Yuchen-Song/Design-and-Manufacturing-II-Course-Project-Spring-2022/README.md

# Design-and-Manufacturing-II-Course-Project-Spring-2022
This is a repository for course materials of Design &amp; Manufacturing II  
You can find an introduction video to our project at [Intro](https://youtu.be/ErCT-_t35Jg)  
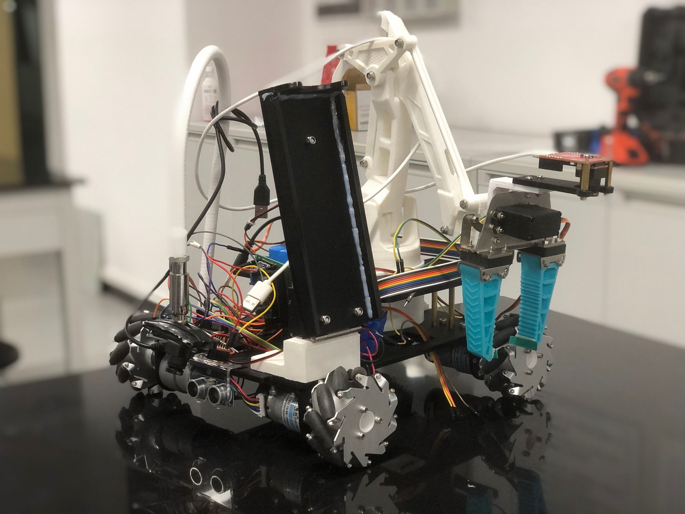
[picture p1: demo.jpg]
