Yuchen-Song/Design-and-Manufacturing-II-Course-Project-Spring-2022/stm32/HARDWARE/MOTOR/motor.h

#ifndef _MOTOR_H
#define _MOTOR_H
#include "sys.h"
	

//motor and Timer init
void F_MOTOR_Init(void);
void B_MOTOR_Init(void);


//控制两个马达的基础函数
void MOTOR_A(int state);
void MOTOR_B(int state);
void MOTOR_C(int state);
void MOTOR_D(int state);

//小车运动函数
void Car_Go(void);
void Car_Back(void);
void Car_Stop(void);
void Car_Turn_Left(void);
void Car_Turn_Right(void);
void Car_Move_Left(void);
void Car_Move_Right(void);
void Car_Turn_lLeft(void);
void Car_Turn_lRight(void);
void setcompare(int Lpwm,int Rpwm);
void pwm_control(int Lpwm,int Rpwm);
#endif
