Yuchen-Song/Design-and-Manufacturing-II-Course-Project-Spring-2022/stm32/HARDWARE/SONIC/sonic.c

#include "sonic.h"
#include "usart.h"
#include "delay.h"

void TIM5_Cap_Init(u16 arr,u16 psc)
{	 
	TIM_ICInitTypeDef  TIM5_ICInitStructure;
	GPIO_InitTypeDef GPIO_InitStructure;
	TIM_TimeBaseInitTypeDef  TIM_TimeBaseStructure;
  NVIC_InitTypeDef NVIC_InitStructure;

	RCC_APB1PeriphClockCmd(RCC_APB1Periph_TIM5, ENABLE);	//使能TIM5时钟
 	RCC_APB2PeriphClockCmd(RCC_APB2Periph_GPIOA, ENABLE);  //使能GPIOA时钟
	
	GPIO_InitStructure.GPIO_Pin  = GPIO_Pin_0;  //PA0 清除之前设置  
	GPIO_InitStructure.GPIO_Mode = GPIO_Mode_IPD; //PA0 输入  
	GPIO_Init(GPIOA, &GPIO_InitStructure);
	GPIO_ResetBits(GPIOA,GPIO_Pin_0);						 //PA0 下拉
	
	GPIO_InitStructure.GPIO_Pin  = GPIO_Pin_1;  //PA1 清除之前设置  
	GPIO_InitStructure.GPIO_Mode = GPIO_Mode_IPD; //PA1 输入  
	GPIO_Init(GPIOA, &GPIO_InitStructure);
	GPIO_ResetBits(GPIOA,GPIO_Pin_1);						 //PA1 下拉
	
	//初始化定时器5 TIM5	 
	TIM_TimeBaseStructure.TIM_Period = arr; //设定计数器自动重装值 
	TIM_TimeBaseStructure.TIM_Prescaler = psc; 	//预分频器   
	TIM_TimeBaseStructure.TIM_ClockDivision = TIM_CKD_DIV1; //设置时钟分割:TDTS = Tck_tim
	TIM_TimeBaseStructure.TIM_CounterMode = TIM_CounterMode_Up;  //TIM向上计数模式
	TIM_TimeBaseInit(TIM5, &TIM_TimeBaseStructure); //根据TIM_TimeBaseInitStruct中指定的参数初始化TIMx的时间基数单位
  
	//初始化TIM5输入捕获参数
	TIM5_ICInitStructure.TIM_Channel = TIM_Channel_1; //CC1S=01 	选择输入端 IC1映射到TI1上
	TIM5_ICInitStructure.TIM_ICPolarity = TIM_ICPolarity_Rising;	//上升沿捕获
	TIM5_ICInitStructure.TIM_ICSelection = TIM_ICSelection_DirectTI; //映射到TI1上
	TIM5_ICInitStructure.TIM_ICPrescaler = TIM_ICPSC_DIV1;	 //配置输入分频,不分频 
	TIM5_ICInitStructure.TIM_ICFilter = 0x00;//IC1F=0000 配置输入滤波器 不滤波
	TIM_ICInit(TIM5, &TIM5_ICInitStructure);
	
	//初始化TIM5输入捕获参数
	TIM5_ICInitStructure.TIM_Channel = TIM_Channel_2; //CC1S=01 	选择输入端 IC1映射到TI1上
	TIM5_ICInitStructure.TIM_ICPolarity = TIM_ICPolarity_Rising;	//上升沿捕获
	TIM5_ICInitStructure.TIM_ICSelection = TIM_ICSelection_DirectTI; //映射到TI1上
	TIM5_ICInitStructure.TIM_ICPrescaler = TIM_ICPSC_DIV1;	 //配置输入分频,不分频 
	TIM5_ICInitStructure.TIM_ICFilter = 0x00;//IC1F=0000 配置输入滤波器 不滤波
	TIM_ICInit(TIM5, &TIM5_ICInitStructure);
	
	//中断分组初始化
	NVIC_InitStructure.NVIC_IRQChannel = TIM5_IRQn;  //TIM3中断
	NVIC_InitStructure.NVIC_IRQChannelPreemptionPriority = 0;  //先占优先级2级
	NVIC_InitStructure.NVIC_IRQChannelSubPriority = 0;  //从优先级0级
	NVIC_InitStructure.NVIC_IRQChannelCmd = ENABLE; //IRQ通道被使能
	NVIC_Init(&NVIC_InitStructure);  //根据NVIC_InitStruct中指定的参数初始化外设NVIC寄存器 
	
	TIM_ITConfig(TIM5,TIM_IT_Update|TIM_IT_CC1|TIM_IT_CC2,ENABLE);//允许更新中断 ,允许CC1IE捕获中断	
	
  TIM_Cmd(TIM5,ENABLE); 	//使能定时器5
}

u8  TIM5CH1_CAPTURE_STA=0;	//输入捕获状态		    				
u16	TIM5CH1_CAPTURE_VAL;	//输入捕获值
u8  TIM5CH2_CAPTURE_STA=0;	//输入捕获状态		    				
u16	TIM5CH2_CAPTURE_VAL;	//输入捕获值
 
//定时器5中断服务程序	 
void TIM5_IRQHandler(void)
{
 	if((TIM5CH1_CAPTURE_STA&0X80)==0)//还未成功捕获	
	{	  
		if (TIM_GetITStatus(TIM5, TIM_IT_Update) != RESET)
		 
		{	    
			if(TIM5CH1_CAPTURE_STA&0X40)//已经捕获到高电平了
			{
				if((TIM5CH1_CAPTURE_STA&0X3F)==0X3F)//高电平太长了
				{
					TIM5CH1_CAPTURE_STA|=0X80;//标记成功捕获了一次
					TIM5CH1_CAPTURE_VAL=0XFFFF;
				}else TIM5CH1_CAPTURE_STA++;
			}	 
		}
	if (TIM_GetITStatus(TIM5, TIM_IT_CC1) != RESET)//捕获1发生捕获事件
		{	
			//printf("Captured!/n");
			if(TIM5CH1_CAPTURE_STA&0X40)		//捕获到一个下降沿 		
			{	  			
				//printf("Captured Down!/n");
				TIM5CH1_CAPTURE_STA|=0X80;		//标记成功捕获到一次高电平脉宽
				TIM5CH1_CAPTURE_VAL=TIM_GetCapture1(TIM5);
		   		TIM_OC1PolarityConfig(TIM5,TIM_ICPolarity_Rising); //CC1P=0 设置为上升沿捕获
			}else  								//还未开始,第一次捕获上升沿
			{
				//printf("Captured Up!/n");
				TIM5CH1_CAPTURE_STA=0;			//清空
				TIM5CH1_CAPTURE_VAL=0;
	 			TIM_SetCounter(TIM5,0);
				TIM5CH1_CAPTURE_STA|=0X40;		//标记捕获到了上升沿
		   		TIM_OC1PolarityConfig(TIM5,TIM_ICPolarity_Falling);		//CC1P=1 设置为下降沿捕获
			}		    
		}	
			
 	}
	if((TIM5CH2_CAPTURE_STA&0X80)==0)//还未成功捕获	
	{	  
		if (TIM_GetITStatus(TIM5, TIM_IT_Update) != RESET)
		 
		{	    
			if(TIM5CH2_CAPTURE_STA&0X40)//已经捕获到高电平了
			{
				if((TIM5CH2_CAPTURE_STA&0X3F)==0X3F)//高电平太长了
				{
					TIM5CH2_CAPTURE_STA|=0X80;//标记成功捕获了一次
					TIM5CH2_CAPTURE_VAL=0XFFFF;
				}else TIM5CH2_CAPTURE_STA++;
			}	 
		}
	if (TIM_GetITStatus(TIM5, TIM_IT_CC2) != RESET)//捕获1发生捕获事件
		{	
			//printf("Captured!/n");
			if(TIM5CH2_CAPTURE_STA&0X40)		//捕获到一个下降沿 		
			{	  			
				//printf("Captured Down!/n");
				TIM5CH2_CAPTURE_STA|=0X80;		//标记成功捕获到一次高电平脉宽
				TIM5CH2_CAPTURE_VAL=TIM_GetCapture2(TIM5);
		   		TIM_OC2PolarityConfig(TIM5,TIM_ICPolarity_Rising); //CC1P=0 设置为上升沿捕获
			}else  								//还未开始,第一次捕获上升沿
			{
				//printf("Captured Up!/n");
				TIM5CH2_CAPTURE_STA=0;			//清空
				TIM5CH2_CAPTURE_VAL=0;
	 			TIM_SetCounter(TIM5,0);
				TIM5CH2_CAPTURE_STA|=0X40;		//标记捕获到了上升沿
		   		TIM_OC2PolarityConfig(TIM5,TIM_ICPolarity_Falling);		//CC1P=1 设置为下降沿捕获
			}		    
		}
	}
 
    TIM_ClearITPendingBit(TIM5, TIM_IT_CC1|TIM_IT_CC2|TIM_IT_Update); //清除中断标志位
 
}


void TIM4_Cap_Init(u16 arr,u16 psc)
{	 
	TIM_ICInitTypeDef  TIM4_ICInitStructure;
	GPIO_InitTypeDef GPIO_InitStructure;
	TIM_TimeBaseInitTypeDef  TIM_TimeBaseStructure;
  NVIC_InitTypeDef NVIC_InitStructure;

	RCC_APB1PeriphClockCmd(RCC_APB1Periph_TIM4, ENABLE);	//使能TIM4时钟
 	RCC_APB2PeriphClockCmd(RCC_APB2Periph_GPIOB, ENABLE);  //使能GPIOB时钟
	
	GPIO_InitStructure.GPIO_Pin  = GPIO_Pin_8;  //PB8 清除之前设置  
	GPIO_InitStructure.GPIO_Mode = GPIO_Mode_IPD; //PB8 输入  
	GPIO_Init(GPIOB, &GPIO_InitStructure);
	GPIO_ResetBits(GPIOB,GPIO_Pin_8);						 //PB8 下拉
	
	
	//初始化定时器4 TIM4 
	TIM_TimeBaseStructure.TIM_Period = arr; //设定计数器自动重装值 
	TIM_TimeBaseStructure.TIM_Prescaler = psc; 	//预分频器   
	TIM_TimeBaseStructure.TIM_ClockDivision = TIM_CKD_DIV1; //设置时钟分割:TDTS = Tck_tim
	TIM_TimeBaseStructure.TIM_CounterMode = TIM_CounterMode_Up;  //TIM向上计数模式
	TIM_TimeBaseInit(TIM4, &TIM_TimeBaseStructure); //根据TIM_TimeBaseInitStruct中指定的参数初始化TIMx的时间基数单位
  
	//初始化TIM4输入捕获参数
	TIM4_ICInitStructure.TIM_Channel = TIM_Channel_3; //CC1S=01 	选择输入端 IC1映射到TI1上
	TIM4_ICInitStructure.TIM_ICPolarity = TIM_ICPolarity_Rising;	//上升沿捕获
	TIM4_ICInitStructure.TIM_ICSelection = TIM_ICSelection_DirectTI; //映射到TI1上
	TIM4_ICInitStructure.TIM_ICPrescaler = TIM_ICPSC_DIV1;	 //配置输入分频,不分频 
	TIM4_ICInitStructure.TIM_ICFilter = 0x00;//IC1F=0000 配置输入滤波器 不滤波
	TIM_ICInit(TIM4, &TIM4_ICInitStructure);
	
	//中断分组初始化
	NVIC_InitStructure.NVIC_IRQChannel = TIM4_IRQn;  //TIM3中断
	NVIC_InitStructure.NVIC_IRQChannelPreemptionPriority = 2;  //先占优先级2级
	NVIC_InitStructure.NVIC_IRQChannelSubPriority = 0;  //从优先级0级
	NVIC_InitStructure.NVIC_IRQChannelCmd = ENABLE; //IRQ通道被使能
	NVIC_Init(&NVIC_InitStructure);  //根据NVIC_InitStruct中指定的参数初始化外设NVIC寄存器 
	
	TIM_ITConfig(TIM4,TIM_IT_Update|TIM_IT_CC3,ENABLE);//允许更新中断 ,允许更新中断和捕获中断	
	
  TIM_Cmd(TIM4,ENABLE); 	//使能TIM4
}

u8  TIM4CH3_CAPTURE_STA=0;	//输入捕获状态		    				
u16	TIM4CH3_CAPTURE_VAL;	//输入捕获值
 
//定时器5中断服务程序	 
void TIM4_IRQHandler(void)
{
 	if((TIM4CH3_CAPTURE_STA&0X80)==0)//还未成功捕获	
	{	  
		if (TIM_GetITStatus(TIM4, TIM_IT_Update) != RESET)
		 
		{	    
			if(TIM4CH3_CAPTURE_STA&0X40)//已经捕获到高电平了
			{
				if((TIM4CH3_CAPTURE_STA&0X3F)==0X3F)//高电平太长了
				{
					TIM4CH3_CAPTURE_STA|=0X80;//标记成功捕获了一次
					TIM4CH3_CAPTURE_VAL=0XFFFF;
				}else TIM4CH3_CAPTURE_STA++;
			}	 
		}
	if (TIM_GetITStatus(TIM4, TIM_IT_CC3) != RESET)//捕获1发生捕获事件
		{	
			//printf("Captured!/n");
			if(TIM4CH3_CAPTURE_STA&0X40)		//捕获到一个下降沿 		
			{	  			
				//printf("Captured Down!/n");
				TIM4CH3_CAPTURE_STA|=0X80;		//标记成功捕获到一次高电平脉宽
				TIM4CH3_CAPTURE_VAL=TIM_GetCapture3(TIM4);
				TIM_OC3PolarityConfig(TIM4,TIM_ICPolarity_Rising); //CC1P=0 设置为上升沿捕获
			}
			else  								//还未开始,第一次捕获上升沿
			{
				//printf("Captured Up!/n");
				TIM4CH3_CAPTURE_STA=0;			//清空
				TIM4CH3_CAPTURE_VAL=0;
	 			TIM_SetCounter(TIM4,0);
				TIM4CH3_CAPTURE_STA|=0X40;		//标记捕获到了上升沿
				TIM_OC3PolarityConfig(TIM4,TIM_ICPolarity_Falling);		//CC1P=1 设置为下降沿捕获
			}		    
		}	
 	}
	TIM_ClearITPendingBit(TIM4, TIM_IT_CC3|TIM_IT_Update); //清除中断标志位
}

void HC_SR04_Init(void)
{
	GPIO_InitTypeDef GPIO_InitStructure;
	RCC_APB2PeriphClockCmd(RCC_APB2Periph_GPIOA, ENABLE);	 //??PA????
 	RCC_APB2PeriphClockCmd(RCC_APB2Periph_GPIOC, ENABLE);  //使能GPIOC时钟
	
	GPIO_InitStructure.GPIO_Pin = GPIO_Pin_4;				 // ??????(Trig)??PA4
	GPIO_InitStructure.GPIO_Mode = GPIO_Mode_Out_PP; 		 //????
	GPIO_InitStructure.GPIO_Speed = GPIO_Speed_50MHz;		 //IO????50MHz
	GPIO_Init(GPIOA, &GPIO_InitStructure);	
	
	GPIO_ResetBits(GPIOA,GPIO_Pin_4);
	
	GPIO_InitStructure.GPIO_Pin = GPIO_Pin_4;				 // ??????(Trig)??PA4
	GPIO_InitStructure.GPIO_Mode = GPIO_Mode_Out_PP; 		 //????
	GPIO_InitStructure.GPIO_Speed = GPIO_Speed_50MHz;		 //IO????50MHz
	GPIO_Init(GPIOC, &GPIO_InitStructure);	
	
	GPIO_ResetBits(GPIOC,GPIO_Pin_4);
	
	GPIO_InitStructure.GPIO_Pin = GPIO_Pin_5;				 // ??????(Trig)??PA4
	GPIO_InitStructure.GPIO_Mode = GPIO_Mode_Out_PP; 		 //????
	GPIO_InitStructure.GPIO_Speed = GPIO_Speed_50MHz;		 //IO????50MHz
	GPIO_Init(GPIOC, &GPIO_InitStructure);	
	
	GPIO_ResetBits(GPIOC,GPIO_Pin_5);
}

float HC_SR04_GetDis(u8 a)
{
	float Distance = 0.0;
	u32 temp=0; 
	if (a == 1)
	{
		GPIO_SetBits(GPIOA,GPIO_Pin_4);    //TRIG??
		delay_us(20);
		GPIO_ResetBits(GPIOA,GPIO_Pin_4);  //TRIG??

		if(TIM5CH1_CAPTURE_STA&0X80)//成功捕获到了一次上升沿
		{
			temp=TIM5CH1_CAPTURE_STA&0X3F;
			temp*=65536;//溢出时间总和
			temp+=TIM5CH1_CAPTURE_VAL;//得到总的高电平时间
			Distance = temp*0.017;
			printf("HIGH-1:%.2f cm\r\n",Distance);//打印总的高点平时间
			TIM5CH1_CAPTURE_STA=0;//开启下一次捕获
			return Distance;
		}
	}
	else if (a == 3)
	{
		GPIO_SetBits(GPIOC,GPIO_Pin_4);    //TRIG??
		delay_us(20);
		GPIO_ResetBits(GPIOC,GPIO_Pin_4);  //TRIG??

		if(TIM5CH2_CAPTURE_STA&0X80)//成功捕获到了一次上升沿
			{
				temp=TIM5CH2_CAPTURE_STA&0X3F;
				temp*=65536;//溢出时间总和
				temp+=TIM5CH2_CAPTURE_VAL;//得到总的高电平时间
				Distance = temp*0.017;
				printf("HIGH-2:%.2f cm\r\n",Distance);//打印总的高点平时间
				TIM5CH2_CAPTURE_STA=0;//开启下一次捕获
				return Distance;
		}
	}
	else if (a == 2)
	{
		GPIO_SetBits(GPIOC,GPIO_Pin_5);    //TRIG??
		delay_us(20);
		GPIO_ResetBits(GPIOC,GPIO_Pin_5);  //TRIG??

		if(TIM4CH3_CAPTURE_STA&0X80)//成功捕获到了一次上升沿
		{
			temp=TIM4CH3_CAPTURE_STA&0X3F;
			temp*=65536;//溢出时间总和
			temp+=TIM4CH3_CAPTURE_VAL;//得到总的高电平时间
			Distance = temp*0.017;
			printf("HIGH-3:%.2f cm\r\n",Distance);//打印总的高点平时间
			TIM4CH3_CAPTURE_STA=0;//开启下一次捕获
			return Distance;
		}
	}
}
