Yuchen-Song/Design-and-Manufacturing-II-Course-Project-Spring-2022/stm32/HARDWARE/MPU6050/mpu6050.h

#ifndef _MPU6050_H__
#define _MPU6050_H__

#include "stm32f10x.h"

#define DEV_ADDR	0xD0	// 6050 器件地址

//-----------------------------------------
// 定义MPU6050内部地址
//-----------------------------------------
#define	SMPLRT_DIV		0x19	//陀螺仪采样率，典型值：0x07(125Hz)
#define	CONFIG			0x1A	//低通滤波频率，典型值：0x06(5Hz)
#define	GYRO_CONFIG		0x1B	//陀螺仪自检及测量范围，典型值：0x18(不自检，2000deg/s)
#define	ACCEL_CONFIG	0x1C	//加速计自检、测量范围及高通滤波频率，典型值：0x01(不自检，2G，5Hz)

/* 加速度相关寄存器地址 */
#define	ACCEL_XOUT_H	0x3B
#define	ACCEL_XOUT_L	0x3C
#define	ACCEL_YOUT_H	0x3D
#define	ACCEL_YOUT_L	0x3E
#define	ACCEL_ZOUT_H	0x3F
#define	ACCEL_ZOUT_L	0x40

/* 温度相关寄存器地址 */
#define	TEMP_OUT_H		0x41
#define	TEMP_OUT_L		0x42

/* 陀螺仪相关寄存器地址 */
#define	GYRO_XOUT_H		0x43
#define	GYRO_XOUT_L		0x44	
#define	GYRO_YOUT_H		0x45
#define	GYRO_YOUT_L		0x46
#define	GYRO_ZOUT_H		0x47
#define	GYRO_ZOUT_L		0x48

#define	PWR_MGMT_1		0x6B	//电源管理，典型值：0x00(正常启用)
#define	WHO_AM_I		0x75	//IIC地址寄存器(默认数值0x68，只读)
#define	SlaveAddress	0xD0	//IIC写入时的地址字节数据，+1为读取

/* 中断相关寄存器地址 */
#define MPU_INT_EN_REG			0X38	//中断使能寄存器
#define MPU_INTBP_CFG_REG		0X37	//中断/旁路设置寄存器

/* 部分变量 */
#define dt 0.008  // 间隔8ms
#define ZERO_OFFSET_COUN 125 // 125次 * 8ms = 2s

/******************************************************************************
* 函数介绍： MPU6050 初始化函数
* 输入参数： 无
* 输出参数： 无
* 返回值 ：  无
* 备   注：  配置 MPU6050 测量范围：± 2000 °/s  ± 2g
******************************************************************************/
void MPU6050_Init(void);

/******************************************************************************
* 函数介绍： MPU6050 外部中断初始化函数
* 输入参数： 无
* 输出参数： 无
* 返回值 ：  无
* 备   注：  用 PB5 的外部中断，前面设置低电平触发，所以这里要上拉
******************************************************************************/
void MPU6050_EXTI_Init(void);

/******************************************************************************
* 函数介绍： MPU6050 写寄存器函数
* 输入参数： regAddr：寄存器地址
             regData：待写入寄存器值
* 输出参数： 无
* 返回值 ：  无
******************************************************************************/
void MPU6050_Write_Reg(uint8_t regAddr, uint8_t regData);

/******************************************************************************
* 函数介绍： MPU6050 读寄存器函数
* 输入参数： regAddr：寄存器地址
* 输出参数： 无
* 返回值 ：  regData：读出的寄存器数据
******************************************************************************/
uint8_t MPU6050_Read_Reg(uint8_t regAddr);

/******************************************************************************
* 函数介绍： 连续读两个寄存器并合成 16 位数据
* 输入参数： regAddr：寄存器地址
* 输出参数： 无
* 返回值 ：  data：2 个寄存器合成的 16 位数据
******************************************************************************/
int16_t MPU6050_Get_Data(uint8_t regAddr);

/******************************************************************************
* 函数介绍： 读取Yaw
* 输入参数： 无
* 输出参数： 无
* 返回值 ：  无
* 备   注：  无
******************************************************************************/
float MPU6050_Get_Yaw(void);

#endif /* #ifndef _MPU6050_H__ */
