Yuchen-Song/Design-and-Manufacturing-II-Course-Project-Spring-2022/stm32/HARDWARE/SONIC/sonic.h

#include "sys.h"

void TIM5_Cap_Init(u16 arr,u16 psc);

void TIM4_Cap_Init(u16 arr,u16 psc);

void TIM4_IRQHandler(void);

void TIM5_IRQHandler(void);

void HC_SR04_Init(void);

float HC_SR04_GetDis(u8 a);
