Yuchen-Song/Design-and-Manufacturing-II-Course-Project-Spring-2022/(notices)

Notices in the files:
stm32/HARDWARE/IMU/i2c.c:
Copyright (c) 2016-2017, ¹ú¼Ê¸çµÄ¶ÀÁ¢²©¿Í
All rights reserved.
stm32/SYSTEM/usart/usart.c:
Copyright(C) ¹ãÖÝÊÐÐÇÒíµç×Ó¿Æ¼¼ÓÐÏÞ¹«Ë¾ 2009-2019
stm32/HARDWARE/PWM/pwm.c:
Copyright(C) ÕýµãÔ­×Ó 2009-2019
